kyma-un/myoki-board/manufacturing/bom/myoki-bom.xlsx

 |  | MYOKI IMU · Bill of Materials
 |  | Lista de materiales · Sensores y Actuadores · Supported by KYMA UN
 |  | Versión 1.1 · Cotización en Bogotá (Sigma Electrónica y Vistrónica) del 2026-11-09 · COP
ID | Nombre | Descripción | Función | Costo unitario | Cantidad | Costo total | Link de compra | Proveedor | Precio Sigma | Stock Sigma | Link Sigma | Precio Vistrónica | Stock Vistrónica | Link Vistrónica | Notas
PLACA BASE · ESP32-C3
B-01 | ESP32-C3 SuperMini | Módulo MCU RISC-V con Wi-Fi, BLE y USB-C (U1) | Procesamiento, lectura de sensores y comunicación | $12900.0 | 1 | $12900 | Comprar (https://www.sigmaelectronica.net/producto/tarj-esp32-c3-4mb/) | Vistrónica | $13685.0 | Sin existencias | Sigma (https://www.sigmaelectronica.net/producto/tarj-esp32-c3-4mb/) | $12900.0 | Compra internacional, 20 días hábiles | Vistrónica (https://www.vistronica.com/iot-internet-de-las-cosas/esp32-c3-super-mini-con-wi-fi-y-bluetooth-50-detail.html) | Ambas tiendas sin stock inmediato. Confirmar antes de comprar.
B-02 | Condensador 100 nF | Condensador cerámico SMD (C1, C2, C3) | Desacople de la alimentación | $119.0 | 3 | $357 | Comprar (https://www.sigmaelectronica.net/producto/cc0805-0-1uf50/) | Sigma | $119.0 | 9560 disponibles | Sigma (https://www.sigmaelectronica.net/producto/cc0805-0-1uf50/) |  | Solo THT (no SMD) | Vistrónica (https://www.vistronica.com/componentes-pasivos/capacitores/condensador-ceramico-104-01uf-100nf--detail.html) | Sigma solo tiene 100 nF en 0805 (no 1206). El 0805 se puede soldar sobre los pads 1206 hand-solder.
B-03 | Resistencia 330 Ω 1206 | Resistencia SMD 1206 1/4 W (R1) | Limitación de corriente del LED | $60.0 | 1 | $60 | Comprar (https://www.sigmaelectronica.net/producto/p330ect/) | Sigma | $60.0 | 7 disponibles | Sigma (https://www.sigmaelectronica.net/producto/p330ect/) | $23.8 | 183 paquetes | Vistrónica (https://www.vistronica.com/componentes-pasivos/resistencias/resistencias-330-ohm-smd-1206-14w-5-x10-detail.html) | Vistrónica vende paquete x10 a $238 ($23.8 c/u).
B-04 | LED rojo SMD | LED SMD rojo (D1) | Indicador de encendido / estado | $47.6 | 1 | $47.6 | Comprar (https://www.sigmaelectronica.net/producto/led-0805-rojo/) | Vistrónica | $238.0 | 11029 disponibles · 0805 | Sigma (https://www.sigmaelectronica.net/producto/led-0805-rojo/) | $47.6 | 263 paquetes · 1206 | Vistrónica (https://www.vistronica.com/componentes-activos/diodos/led/led-rojo-smd-1206-x10-detail.html) | El footprint actual es 2010; ninguna tienda lo vende. Recomendado cambiar el footprint a 1206. Vistrónica: paquete x10 a $476.
B-05 | Conector hembra 1×04 2.54 mm | Pin socket vertical (J1 SPI, J2 I²C) | Interconexión con las capas de sensores | $298.0 | 2 | $596 | Comprar (https://www.sigmaelectronica.net/producto/reg-40-x-1-h/) | Vistrónica | $142.8 | 249 disponibles · regleta 1×40 | Sigma (https://www.sigmaelectronica.net/producto/reg-40-x-1-h/) | $298.0 | 403 disponibles · 1×4 | Vistrónica (https://www.vistronica.com/conectores-cables-y-switches/regleta-hembra-2-54mm-4p-detail.html) | Sigma: regleta 1×40 a $1.428, se corta en 10 piezas de 4 pines. Vistrónica vende la 1×4 exacta.
B-06 | PCB base | PCB FR-4 2 capas, 1.6 mm, 38.1 × 38.1 mm | Soporte y conexionado de la base |  | 1 |  |  | Externo |  | No aplica |  |  | No aplica |  | Fabricar con los gerbers (JLCPCB, PCBWay o fabricante local).
Subtotal |  |  |  |  |  | $13960.6
CAPA IMU · BMI160
L1-01 | Módulo GY-BMI160 | Breakout del sensor Bosch BMI160 (U1) | Acelerómetro + giróscopo de 6 ejes | $9996.0 | 1 | $9996 | Comprar (https://www.sigmaelectronica.net/producto/tarjeta-bmi160/) | Sigma | $9996.0 | Sin existencias | Sigma (https://www.sigmaelectronica.net/producto/tarjeta-bmi160/) |  | No lo vende |  | Sin stock en Sigma. Alternativa en Bogotá: Electronilab $18.900 (disponible).
L1-02 | Conector hembra 1×04 2.54 mm | Pin socket vertical (J1, J2) | Paso de buses SPI / I²C en el stack | $298.0 | 2 | $596 | Comprar (https://www.sigmaelectronica.net/producto/reg-40-x-1-h/) | Vistrónica | $142.8 | 249 disponibles · regleta 1×40 | Sigma (https://www.sigmaelectronica.net/producto/reg-40-x-1-h/) | $298.0 | 403 disponibles · 1×4 | Vistrónica (https://www.vistronica.com/conectores-cables-y-switches/regleta-hembra-2-54mm-4p-detail.html) | Ver nota del conector en la placa base.
L1-03 | PCB capa BMI160 | PCB FR-4 2 capas, 1.6 mm, 38.1 × 38.1 mm | Soporte del módulo BMI160 |  | 1 |  |  | Externo |  | No aplica |  |  | No aplica |  | Fabricar con los gerbers.
Subtotal |  |  |  |  |  | $10592
CAPA MAGNETÓMETRO · GY-271
L2-01 | Módulo GY-271 | Magnetómetro de 3 ejes HMC5883L / QMC5883L (U1) | Medición del campo magnético / rumbo | $11900.0 | 1 | $11900 | Comprar (https://www.vistronica.com/sensores/imu/modulo-compas-brujula-digital-hmc5883l-detail.html) | Vistrónica |  | No lo vende |  | $11900.0 | 9 disponibles | Vistrónica (https://www.vistronica.com/sensores/imu/modulo-compas-brujula-digital-hmc5883l-detail.html) | Puede venir con QMC5883L (I²C 0x0D) en lugar de HMC5883L (0x1E).
L2-02 | Conector hembra 1×04 2.54 mm | Pin socket vertical (J1, J2) | Paso de buses SPI / I²C en el stack | $298.0 | 2 | $596 | Comprar (https://www.sigmaelectronica.net/producto/reg-40-x-1-h/) | Vistrónica | $142.8 | 249 disponibles · regleta 1×40 | Sigma (https://www.sigmaelectronica.net/producto/reg-40-x-1-h/) | $298.0 | 403 disponibles · 1×4 | Vistrónica (https://www.vistronica.com/conectores-cables-y-switches/regleta-hembra-2-54mm-4p-detail.html) | Ver nota del conector en la placa base.
L2-03 | PCB capa GY-271 | PCB FR-4 2 capas, 1.6 mm, 38.1 × 38.1 mm | Soporte del módulo GY-271 |  | 1 |  |  | Externo |  | No aplica |  |  | No aplica |  | Fabricar con los gerbers.
Subtotal |  |  |  |  |  | $12496
MECÁNICA · CARCASA
M-01 | Separador M3 10 mm | Poste hexagonal de latón M3, macho/hembra | Separación entre placas del stack | $1428.0 | 8 | $11424 | Comprar (https://www.sigmaelectronica.net/producto/poste-met-10mm/) | Sigma | $1428.0 | 910 disponibles | Sigma (https://www.sigmaelectronica.net/producto/poste-met-10mm/) |  | Solo en kit surtido | Vistrónica (https://www.vistronica.com/herramientas/tornilleria-/kit-de-separadores-y-tuercas-m3-surtidos-detail.html) | Sigma incluye tornillo y tuerca. Vistrónica: kit surtido M3 a $12.482 (10× M3x10+6 y otros).
M-02 | Tornillo M3 | Tornillo M3 cabeza redonda | Fijación del stack | $0.0 | 8 | $0 | Comprar (https://www.sigmaelectronica.net/producto/poste-met-10mm/) | Sigma | $0.0 | Incluido con el poste | Sigma (https://www.sigmaelectronica.net/producto/poste-met-10mm/) | $119.0 | Fuera de stock · M3x8 | Vistrónica (https://www.vistronica.com/tornilleria-/) | Con los postes de Sigma no hace falta comprarlos aparte.
M-03 | Base de carcasa | Impresión 3D (base_plastic_v03.stl) | Alojamiento y montaje con orejas de fijación |  | 1 |  |  | Externo |  | No aplica |  |  | No aplica |  | Servicio de impresión 3D.
M-04 | Marco superior de carcasa | Impresión 3D (plastic_case_top.stl) | Cierre de la carcasa |  | 1 |  |  | Externo |  | No aplica |  |  | No aplica |  | Servicio de impresión 3D.
M-05 | Tapa de acrílico | Corte láser (acrylic_drawing.dxf) con el diseño de la tapa | Tapa visible con logo y ejes de referencia |  | 1 |  |  | Externo |  | No aplica |  |  | No aplica |  | Servicio de corte láser e impresión del diseño.
Subtotal |  |  |  |  |  | $11424
TOTAL COMPONENTES POR UNIDAD MYOKI |  |  |  |  |  | $48472.6
No incluye PCB, impresión 3D, corte láser ni envío (filas marcadas como Externo).
Unidades a fabricar |  | 1
Costo total del lote |  | $48472.6
Cómo usar: cambia la columna Proveedor (Sigma / Vistrónica) y el costo unitario y el link se actualizan solos. Los precios de paquetes (x10, regleta 1×40) están prorrateados por pieza.
