kyma-un/myoki-board/hardware/myoki-bmi160-layer/myoki-bmi160-layer.step

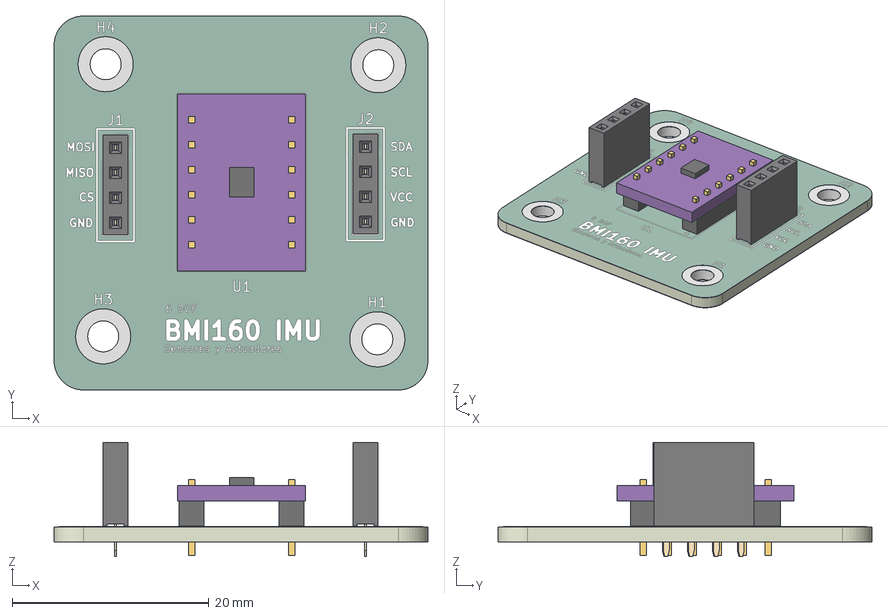
[picture p6: CAD file, 2026-11-09]
hardware/myoki-bmi160-layer/myoki-bmi160-layer.step
38.0 x 38.0 x 11.6 mm
PinSocket_1x04_P2.54mm_Vertical x 2
GY-BMI160
myoki-bmi160-layer_copper
myoki-bmi160-layer_pad
myoki-bmi160-layer_silkscreen
myoki-bmi160-layer_soldermask x 2
myoki-bmi160-layer_PCB_1
myoki-bmi160-layer_PCB_2
myoki-bmi160-layer_PCB_3
myoki-bmi160-layer_PCB_4
myoki-bmi160-layer_PCB_5
