kyma-un/myoki-board/hardware/myoki-mini-esp32-base/myoki-mini-esp32-base.step

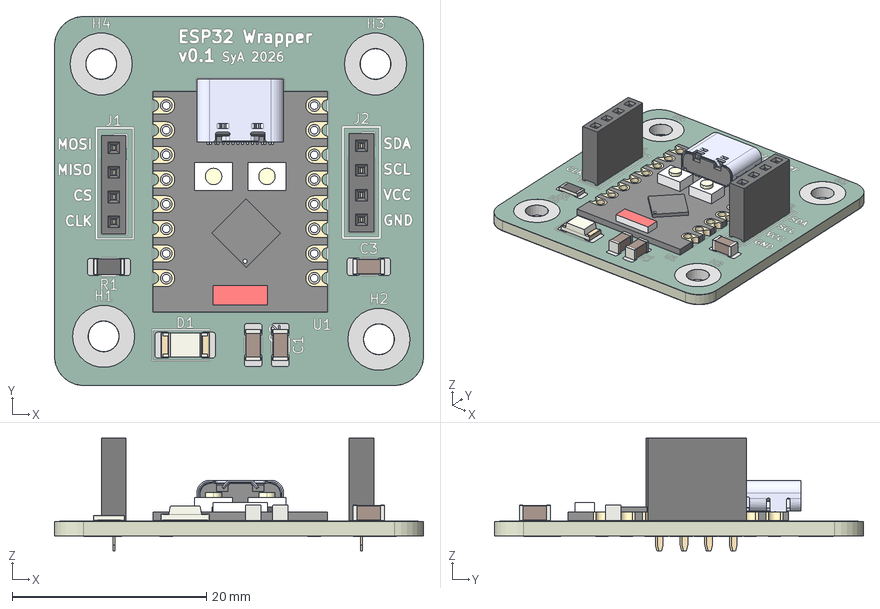
[picture p7: CAD file, 2026-11-08]
hardware/myoki-mini-esp32-base/myoki-mini-esp32-base.step
38.0 x 38.0 x 11.6 mm
C_1206_3216Metric x 3
R_1206_3216Metric
PinSocket_1x04_P2.54mm_Vertical x 2
LED_2010_5025Metric
Board c3mini
USB C
components (other)^ESP32-C3 SuperMini
myoki-mini-esp32-base-unsaved-export-mKBGUP_copper
myoki-mini-esp32-base-unsaved-export-mKBGUP_pad
myoki-mini-esp32-base-unsaved-export-mKBGUP_silkscreen
myoki-mini-esp32-base-unsaved-export-mKBGUP_soldermask x 2
myoki-mini-esp32-base-unsaved-export-mKBGUP_PCB
