kyma-un/myoki-board/manufacturing/enclosure/base_plastic_v03.stl

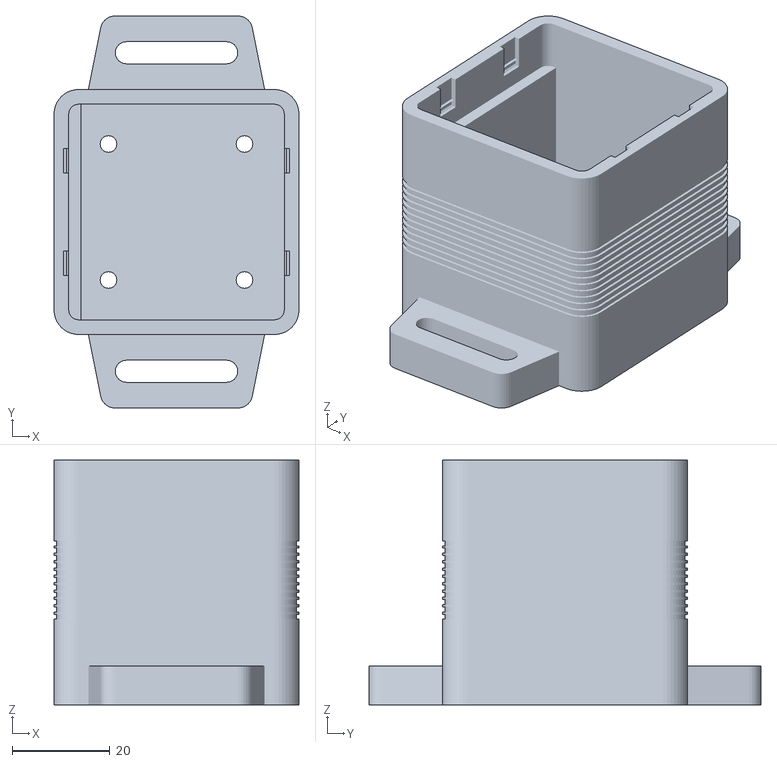
[picture p8: CAD file, 2026-11-09]
manufacturing/enclosure/base_plastic_v03.stl
50.0 x 80.0 x 50.0
