kyma-un/myoki-board/manufacturing/enclosure/top-close.stl

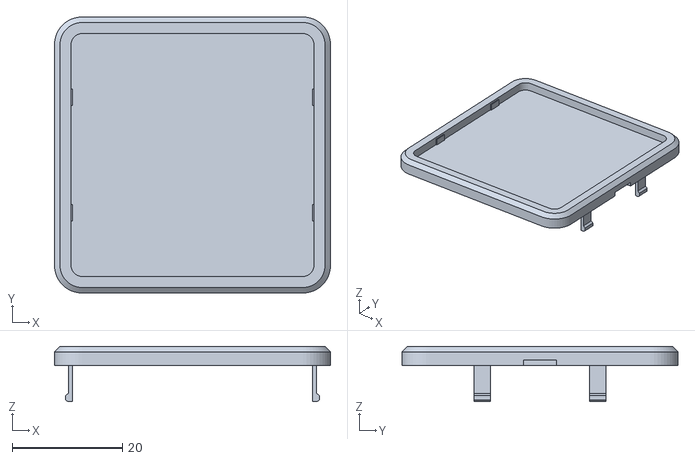
[picture p9: CAD file, 2026-11-09]
manufacturing/enclosure/top-close.stl
50.0 x 50.0 x 10.0
