kyma-un/myoki-board/manufacturing/enclosure/acrylic_drawing.dxf

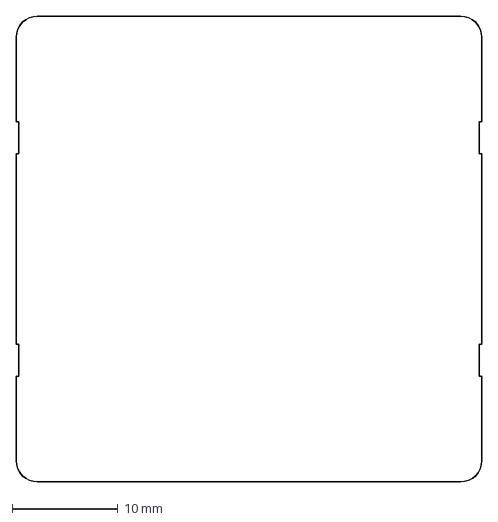
[picture p10: CAD file, 2026-11-09]
manufacturing/enclosure/acrylic_drawing.dxf
44.0 x 44.0 mm
