kyma-un/myoki-board/(list of files, cad)

Other CAD files:
hardware/myoki-gy271-layer/myoki-gy271-layer.step
