kyma-un/myoki-board/hardware/myoki-mini-esp32-base/myoki-mini-esp32-base.kicad_pcb

## KiCad design hardware/myoki-mini-esp32-base/myoki-mini-esp32-base.kicad_pcb (2026-11-12)

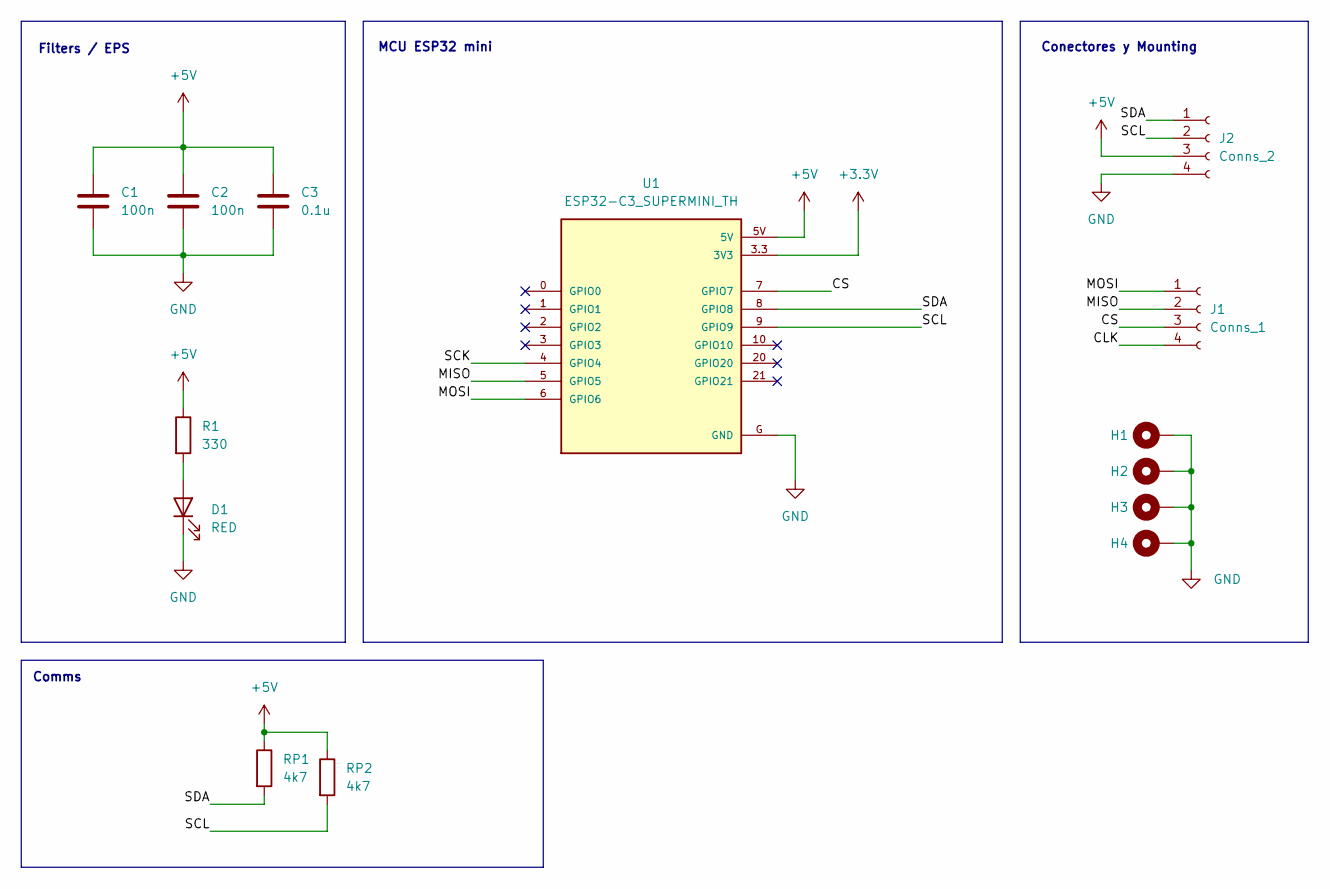
[picture p11: schematic myoki-mini-esp32-base.kicad_sch, PCB ESP32 MINI Base]

Parts:
C1, C2: 100n; C_1206_3216Metric_Pad1.33x1.80mm_HandSolder
C3: 0.1u; C_1206_3216Metric_Pad1.33x1.80mm_HandSolder
D1: RED; LED_2010_5025Metric_Pad1.52x2.65mm_HandSolder
H1, H2, H3, H4: MountingHole_Pad; MountingHole_3.2mm_M3_Pad_TopOnly
J1: Conns_1; PinSocket_1x04_P2.54mm_Vertical
J2: Conns_2; PinSocket_1x04_P2.54mm_Vertical
R1: 330; R_1206_3216Metric_Pad1.30x1.75mm_HandSolder
RP1, RP2: 4k7; R_1206_3216Metric_Pad1.30x1.75mm_HandSolder
U1: ESP32-C3_SUPERMINI_TH; MODULE_ESP32-C3_SUPERMINI_TH

Connections:
+3.3V: U1.3.3 (3V3)
+5V: C1.1, C2.1, C3.1, J2.3, R1.1, RP1.1, RP2.1, U1.5V
/CLK: J1.4
/CS: J1.3, U1.7 (GPIO7)
/MISO: J1.2, U1.5 (GPIO5)
/MOSI: J1.1, U1.6 (GPIO6)
/SCK: U1.4 (GPIO4)
/SCL: J2.2, RP2.2, U1.9 (GPIO9)
/SDA: J2.1, RP1.2, U1.8 (GPIO8)
GND: C1.2, C2.2, C3.2, D1.1 (K), H1.1 (1_1), H2.1 (1_1), H3.1 (1_1), H4.1 (1_1), J2.4, U1.G (GND)
unnamed: D1.2 (A), R1.2

Notes on the sheet:
MCU ESP32 mini
Conectores y Mounting
Filters / EPS
Comms

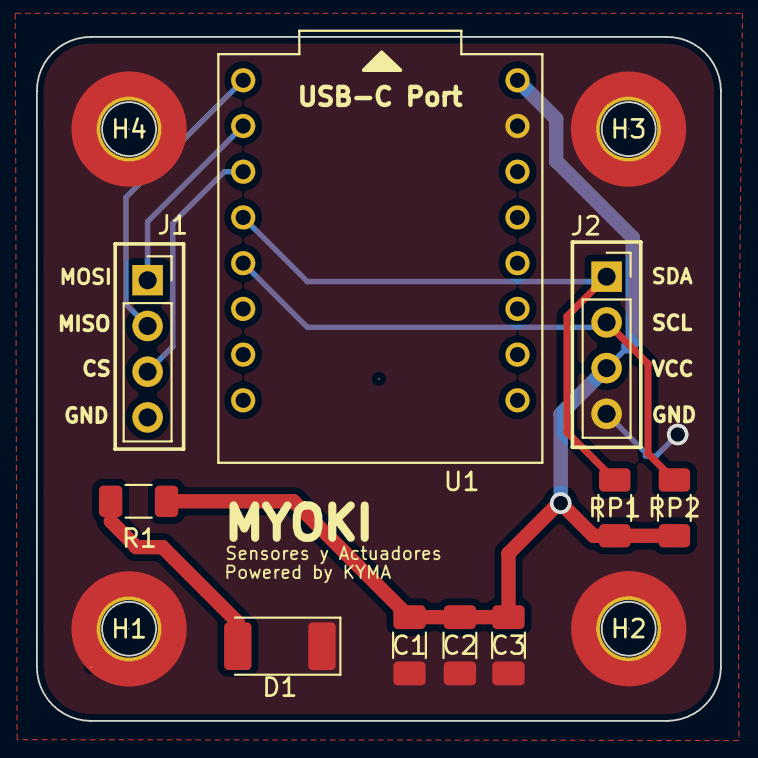
[picture p12: board myoki-mini-esp32-base.kicad_pcb from above]

Board: 2 copper layers, 38.0 x 38.0 mm, 14 parts (0 on the bottom side), 8 nets.
