kyma-un/myoki-board/hardware/myoki-bmi160-layer/myoki-bmi160-layer.kicad_pcb

## KiCad design hardware/myoki-bmi160-layer/myoki-bmi160-layer.kicad_pcb (2026-11-12)

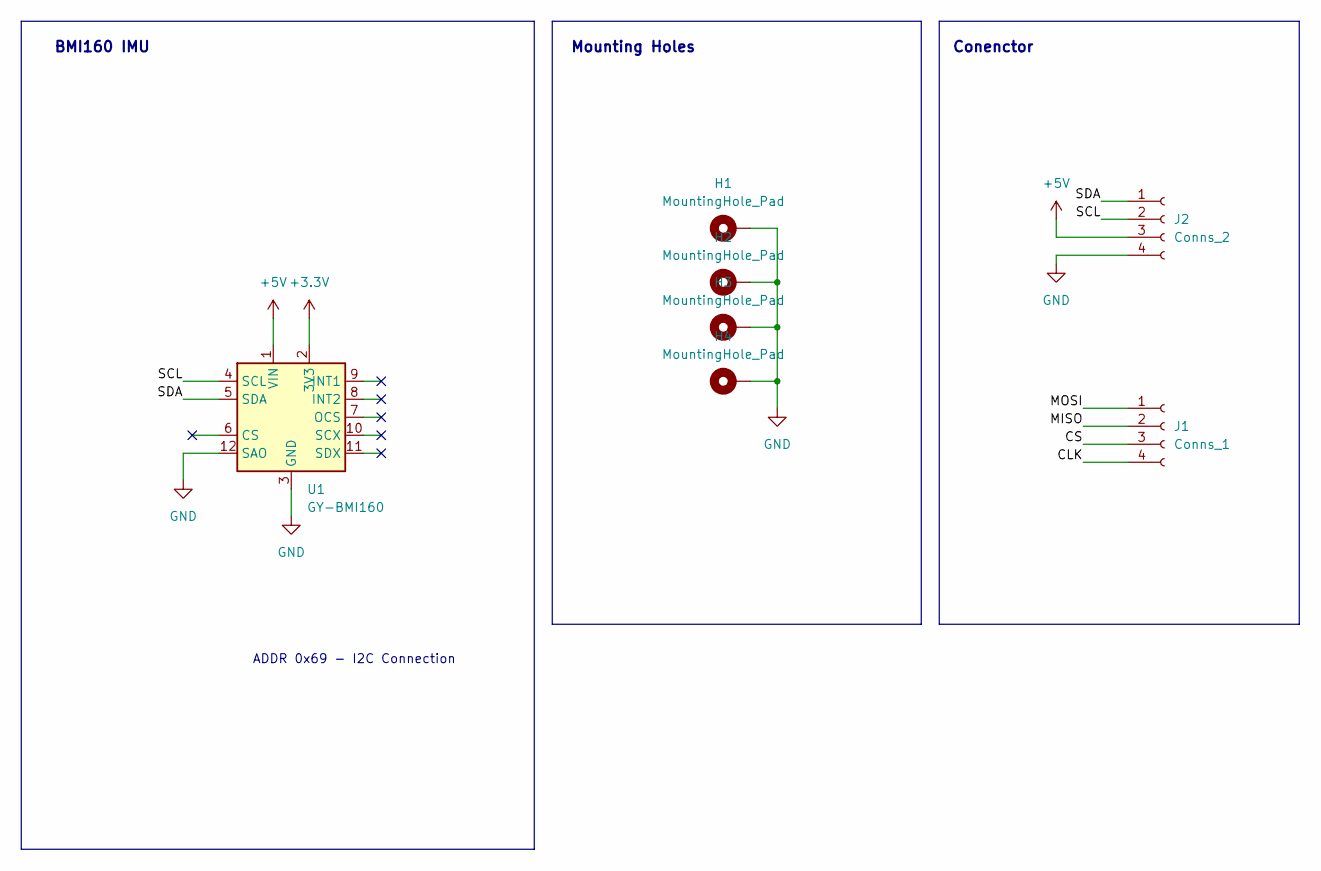
[picture p13: schematic myoki-bmi160-layer.kicad_sch, BMI160 Layer Myoki]

Parts:
H1, H2, H3, H4: MountingHole_Pad; MountingHole_3.2mm_M3_DIN965_Pad
J1: Conns_1; PinSocket_1x04_P2.54mm_Vertical
J2: Conns_2; PinSocket_1x04_P2.54mm_Vertical
U1: GY-BMI160

Connections:
+3.3V: U1.2 (3V3)
+5V: J2.3, U1.1 (VIN)
/CLK: J1.4
/CS: J1.3
/MISO: J1.2
/MOSI: J1.1
/SCL: J2.2, U1.4 (SCL)
/SDA: J2.1, U1.5 (SDA)
GND: H1.1 (1_1), H2.1 (1_1), H3.1 (1_1), H4.1 (1_1), J2.4, U1.3 (GND), U1.12 (SAO)

Notes on the sheet:
Mounting Holes
ADDR 0x69 - I2C Connection
Conenctor
BMI160 IMU

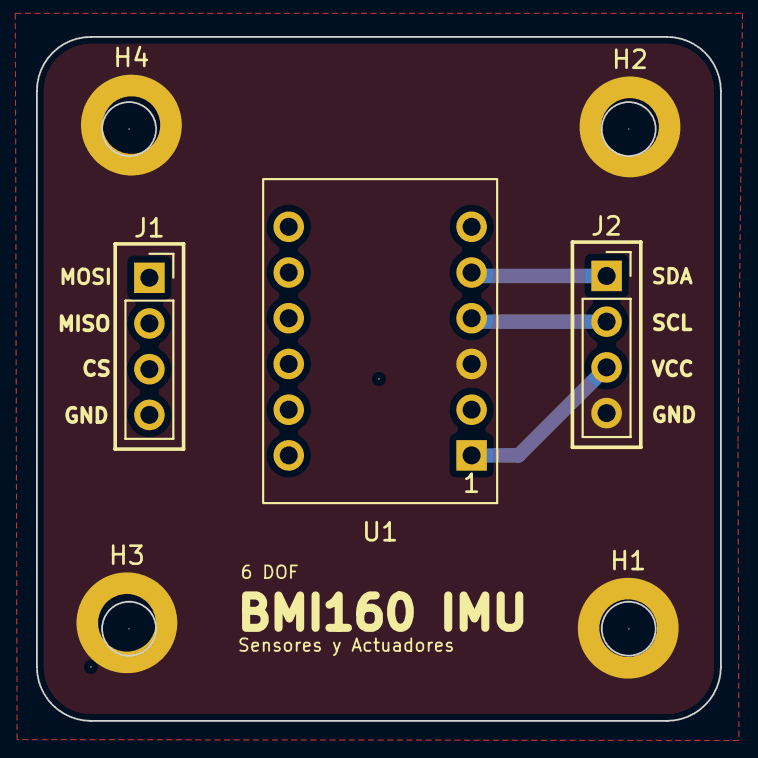
[picture p14: board myoki-bmi160-layer.kicad_pcb from above]

Board: 2 copper layers, 38.0 x 38.0 mm, 7 parts (0 on the bottom side), 4 nets.
