kyma-un/myoki-board/hardware/myoki-gy271-layer/myoki-gy271-layer.kicad_pcb

## KiCad design hardware/myoki-gy271-layer/myoki-gy271-layer.kicad_pcb (2026-11-09)

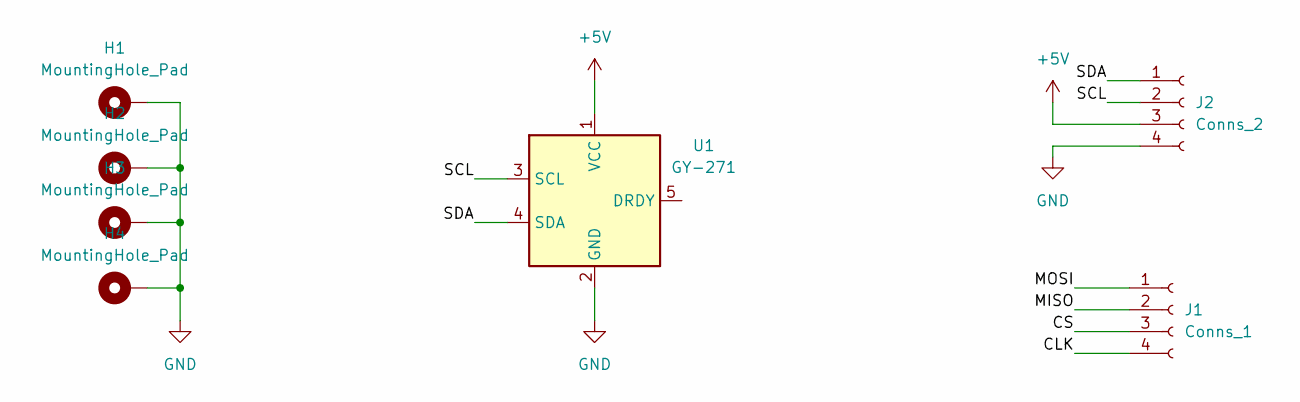
[picture p15: schematic myoki-gy271-layer.kicad_sch]

Parts:
H1, H2, H3, H4: MountingHole_Pad; MountingHole_3.2mm_M3_DIN965_Pad
J1: Conns_1; PinSocket_1x04_P2.54mm_Vertical
J2: Conns_2; PinSocket_1x04_P2.54mm_Vertical
U1: GY-271

Connections:
+5V: J2.3, U1.1 (VCC)
/CLK: J1.4
/CS: J1.3
/MISO: J1.2
/MOSI: J1.1
/SCL: J2.2, U1.3 (SCL)
/SDA: J2.1, U1.4 (SDA)
GND: H1.1 (1_1), H2.1 (1_1), H3.1 (1_1), H4.1 (1_1), J2.4, U1.2 (GND)

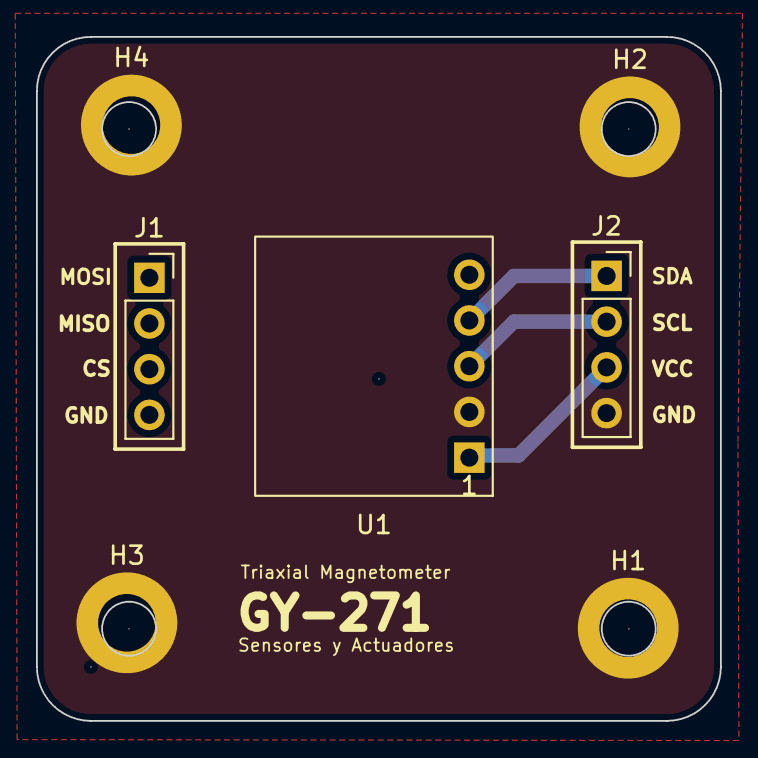
[picture p16: board myoki-gy271-layer.kicad_pcb from above]

Board: 2 copper layers, 38.0 x 38.0 mm, 7 parts (0 on the bottom side), 4 nets.
