kyma-un/myoki-board/(commit log)

2026-11-08 [Update] Lib for ESP32 Mini. Final PCB base Myoki version
    [ESP32-C3_SUPERMINI_TH.step, myoki-mini-esp32-base.kicad_pcb, myoki-mini-esp32-base.kicad_sch, myoki-mini-esp32-base.step, temp-freerouting.dsn]
2026-11-08 [Update] Lib and BMI160 base
    [GY-271.step, GY-BMI160.step, myoki-bmi160-layer.kicad_pcb, myoki-bmi160-layer.kicad_sch, myoki-bmi160-layer.step]
2026-11-08 [Update] Gy271 footprint addesde base
    [myoki-gy271-layer.kicad_pcb, myoki-gy271-layer.kicad_sch, myoki-gy271-layer.step]
2026-11-09 [Checkpoint] Functional Version with initial PCB design and Case (no testing)
    [acrylic_drawing.dxf, base_plastic_v03.stl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]
2026-11-12 [Update] Documentation
    [myoki-bmi160-layer.kicad_pcb, myoki-bmi160-layer.kicad_sch, myoki-bom.xlsx, myoki-mini-esp32-base.kicad_pcb, myoki-mini-esp32-base.kicad_sch, top-close.stl]
2026-11-12 [Update] Kicad HW update schematic for Gy271
    [myoki-gy271-layer.kicad_sch]
